anekos/cq-stackable-container/sample.stl

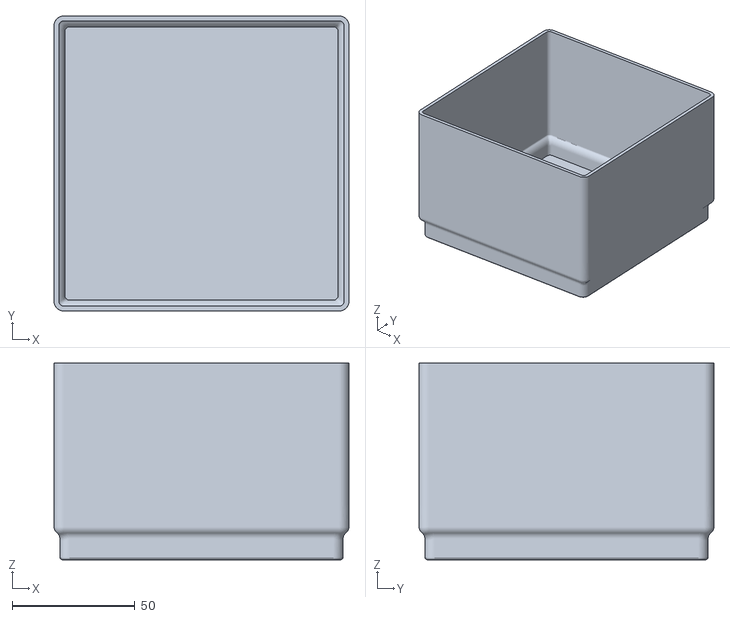
[picture p1: CAD file, 2026-08-11]
sample.stl
120.0 x 120.0 x 80.0
