anekos/cq-stackable-container/(commit log)

2026-08-11 chore: add sample.stl as the reference model
    The container shape to be reproduced: 120 x 120 x 80 mm, 2 mm walls,
    with a stacking foot inset by 2.4 mm per side.
    Claude-Session: https://claude.ai/code/session_01UjjLBxAu3SmVtimaFrKXZQ
    [sample.stl]
2026-08-11 feat: reproduce the sample.stl shape parametrically
    Replace the plain shelled box with the geometry measured off sample.stl:
    a rounded-rect body, a stacking foot inset by thickness + clearance, and
    an S-shaped step between them made of two tangent arcs. The remaining
    dimensions are kept as ratios of the wall thickness so that height,
    width, depth and thickness stay the only parameters.
    Volume matches the reference within 0.006%; the cross-section size
    agrees within 0.007 mm over the full height. The only deviation is at
    the four corners of the step (up to 0.66 mm), where the reference uses
    a 3D rolling-ball blend instead of a swept profile.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
2026-08-11 docs: describe the model, its parameters and how it is built
    Fill in the empty README: usage, the four parameters and the thickness
    ratios derived from them, a cross-section sketch of the body / foot /
    S-shaped step, a walk-through of each function in main.py, and how
    closely the result matches sample.stl.
    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
2026-08-13 feat: add optional dividers along both axes
    The plates split the interior into equal compartments and stop below the
    level where a stacked container's foot comes to rest, so nesting is not
    obstructed. They are cut by the outer body because the wall pulls inward
    around the foot.
    Claude-Session: https://claude.ai/code/session_01L3xmwDWhfEAFPiuXNKAE5w
2026-08-13 docs: clarify why the divider plates are made overlong
    The old wording read as if extending them was the cause of the problem.
    There is no single correct length: the plate has to reach +-58 in the
    body but must stay within +-57.6 around the foot.
    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
2026-08-21 refactor: migrate to click_cadquery's define_app/BuildParam
    Replace the hand-rolled click.Group/define_options boilerplate with
    click_cadquery.define_app, and switch Param to subclass BuildParam.
    Bumps the click-cadquery dependency to >=0.4.0. Behavior is unchanged
    except for the new --screenshot flag that define_app now provides
    alongside --show.
    Claude-Session: https://claude.ai/code/session_01Exhb5thaoMgmPLqqgQTTVd
2026-08-22 chore: sync Makefile with the python-cad-query copier template
    Adds the interactive target (build/watch/setup already matched, or
    are added here too where missing).
